Arjuna1356/WholeSkyImager/Hardware/Drawings/BottomClipDrawing.jpg

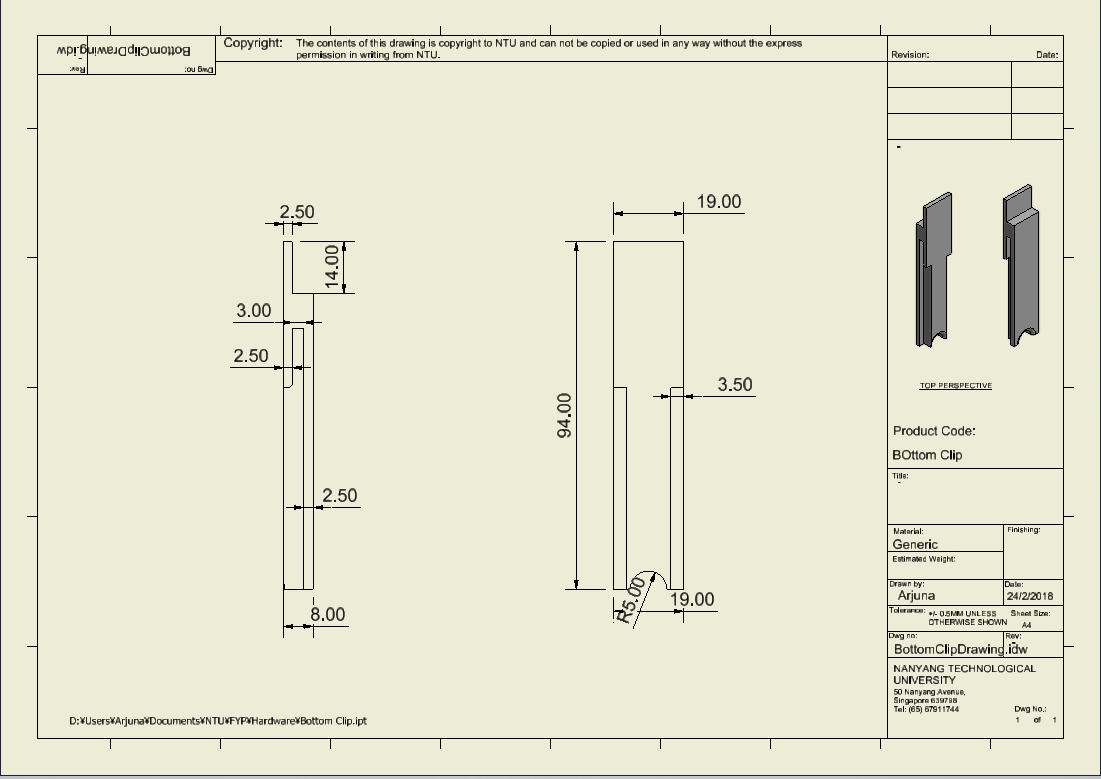
Hardware/Drawings/BottomClipDrawing.jpg
