Arjuna1356/WholeSkyImager/Hardware/Drawings/BottomDrawing.jpg

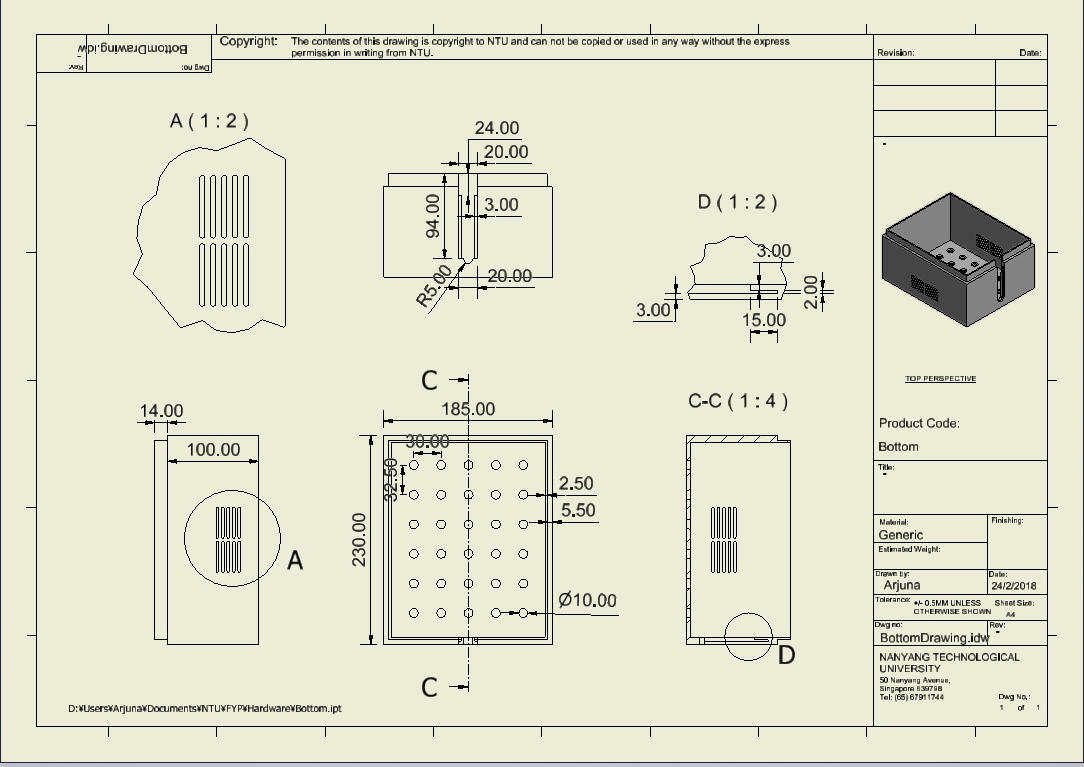
Hardware/Drawings/BottomDrawing.jpg
