Arjuna1356/WholeSkyImager/Hardware/Drawings/BottomRoofDrawing.jpg

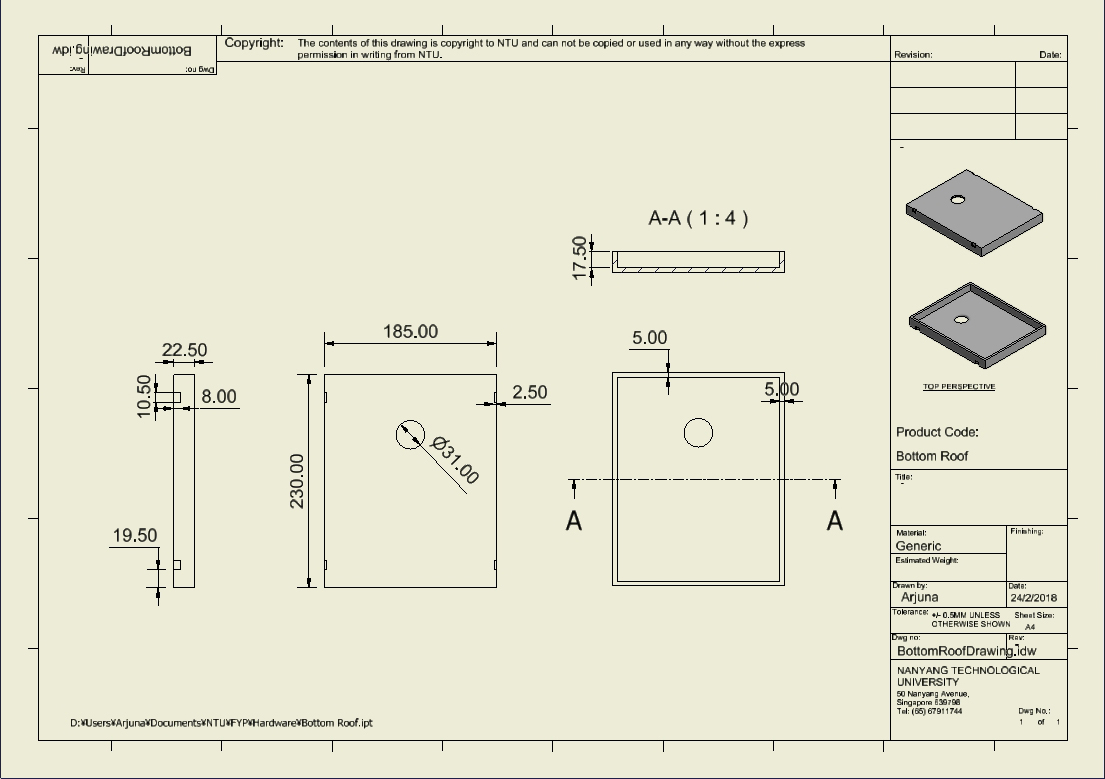
Hardware/Drawings/BottomRoofDrawing.jpg
