Arjuna1356/WholeSkyImager/Hardware/Drawings/DomeClipDrawing.jpg

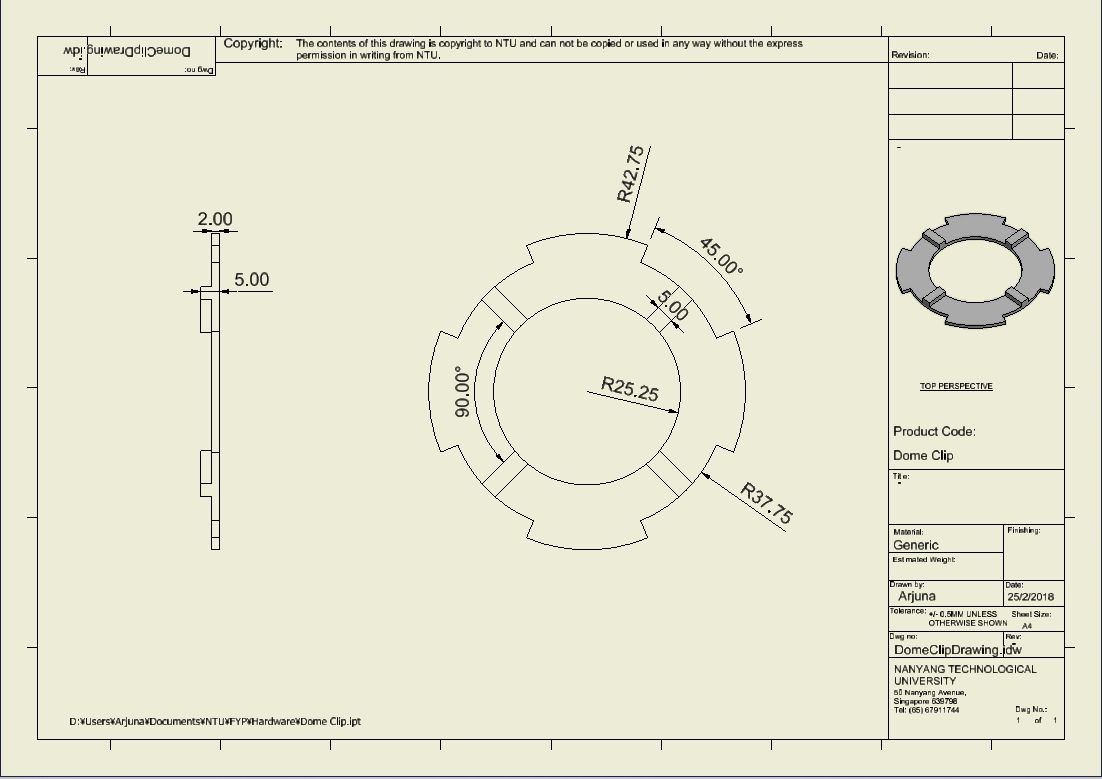
Hardware/Drawings/DomeClipDrawing.jpg
