Arjuna1356/WholeSkyImager/Hardware/Drawings/PlatformPinDrawing.jpg

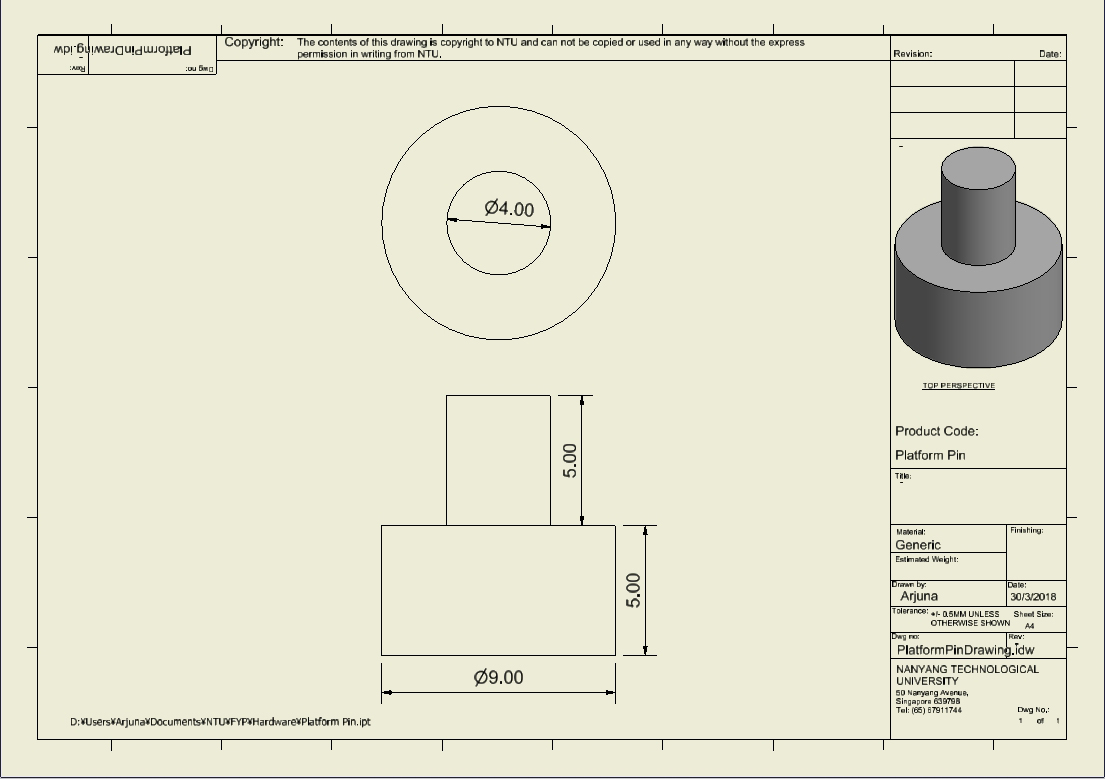
Hardware/Drawings/PlatformPinDrawing.jpg
