Arjuna1356/WholeSkyImager/Hardware/Drawings/RoofExtensionLeftAttachmentDrawing.jpg

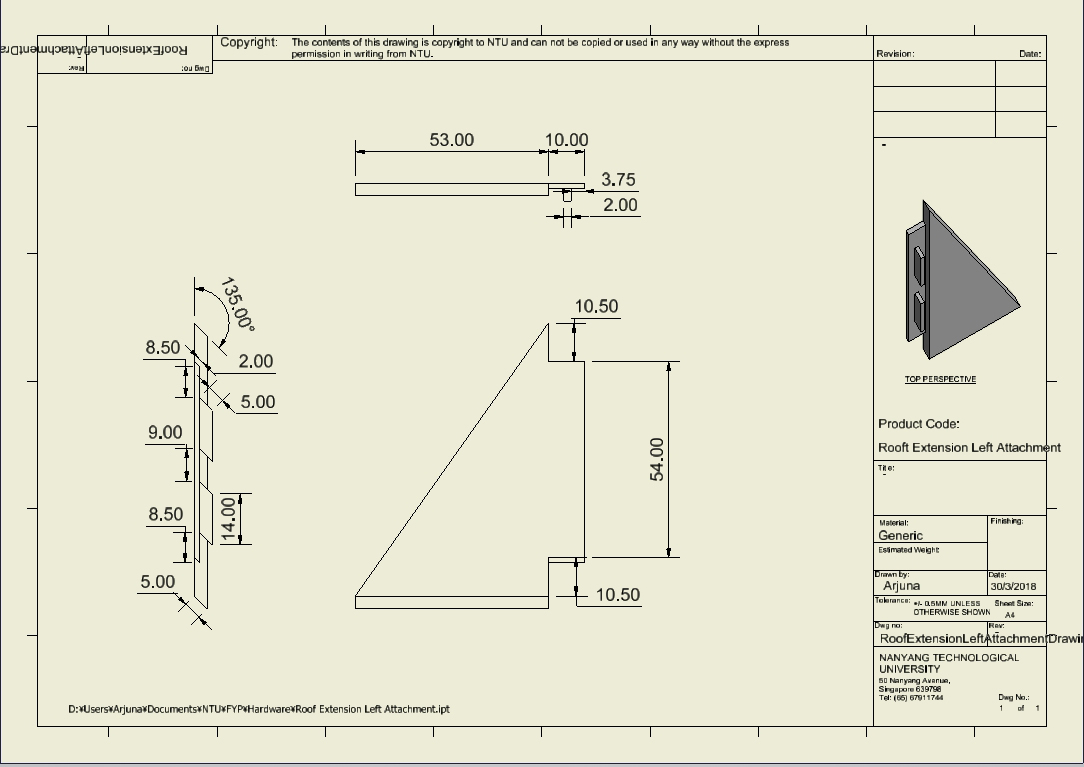
Hardware/Drawings/RoofExtensionLeftAttachmentDrawing.jpg
