Arjuna1356/WholeSkyImager/Hardware/Drawings/RoofExtensionRightAttachmentDrawing.jpg

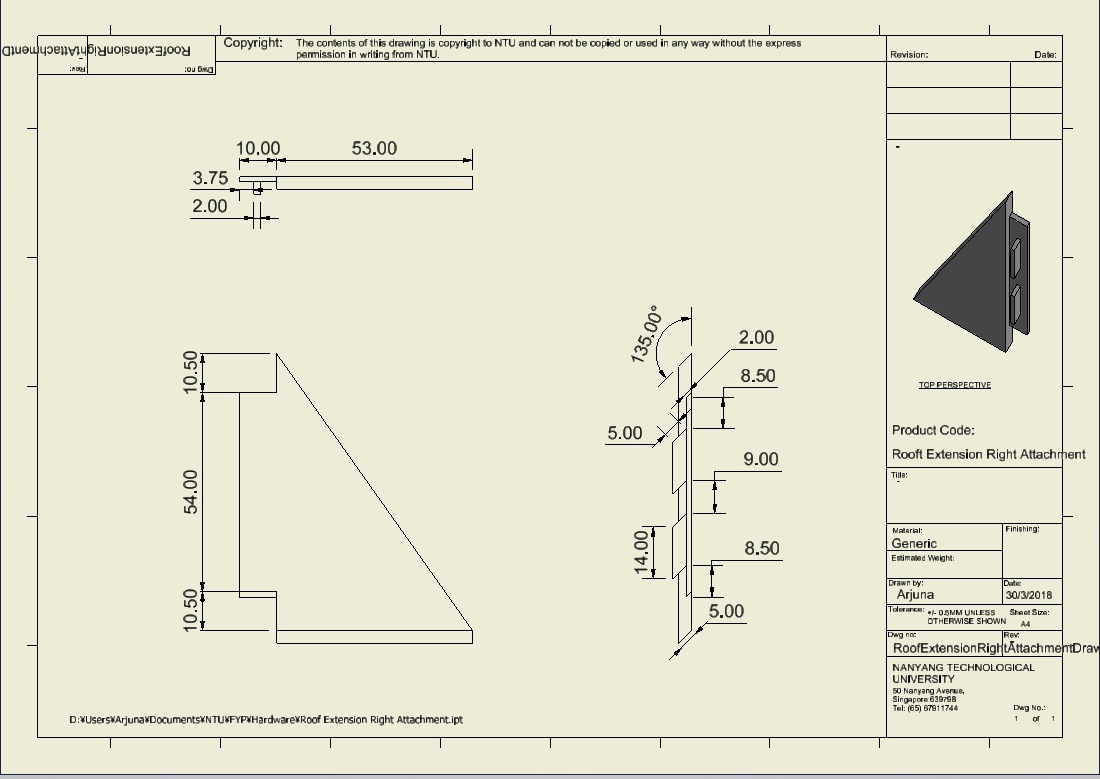
Hardware/Drawings/RoofExtensionRightAttachmentDrawing.jpg
