Arjuna1356/WholeSkyImager/Hardware/Drawings/RoofLengthExtensionDrawing.jpg

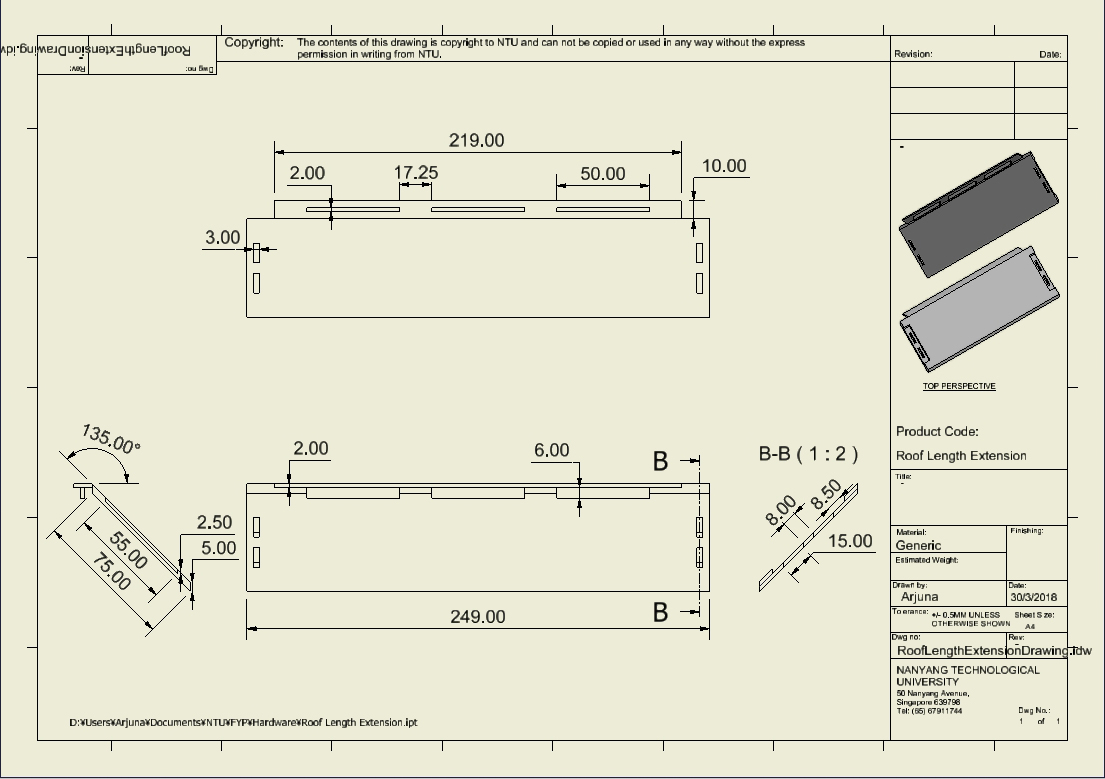
Hardware/Drawings/RoofLengthExtensionDrawing.jpg
