Arjuna1356/WholeSkyImager/Hardware/Drawings/RoofWidthExtensionDrawing.jpg

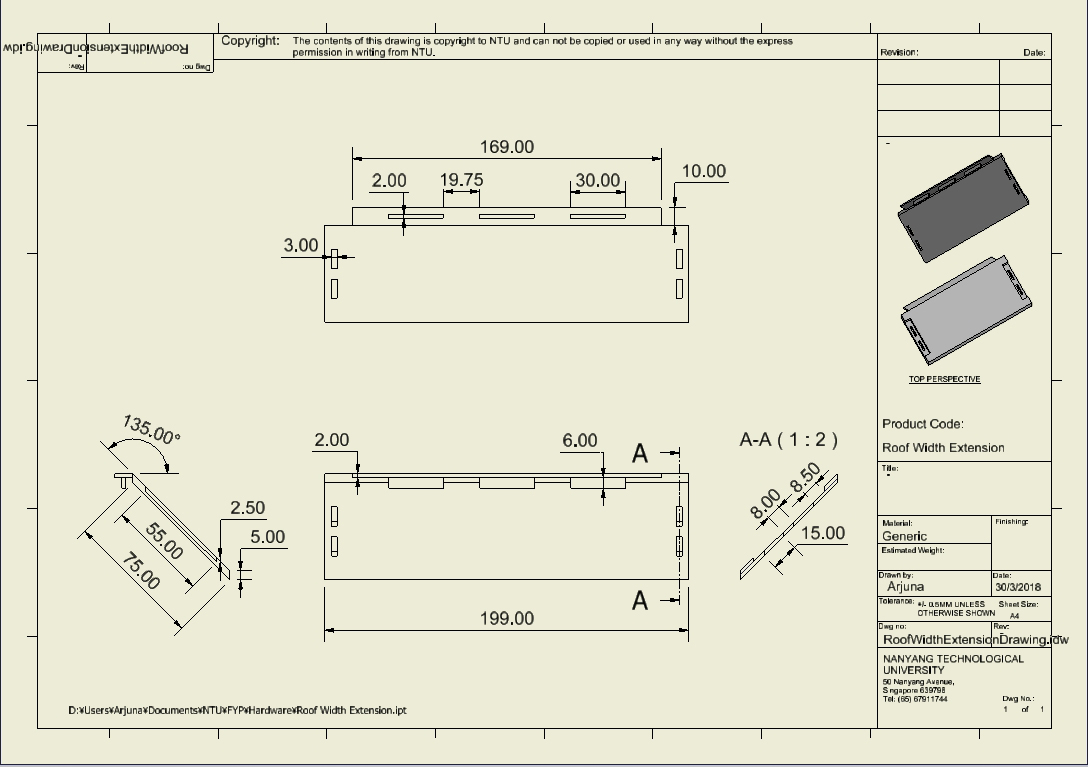
Hardware/Drawings/RoofWidthExtensionDrawing.jpg
