Arjuna1356/WholeSkyImager/Hardware/Drawings/TopRoofDrawing.jpg

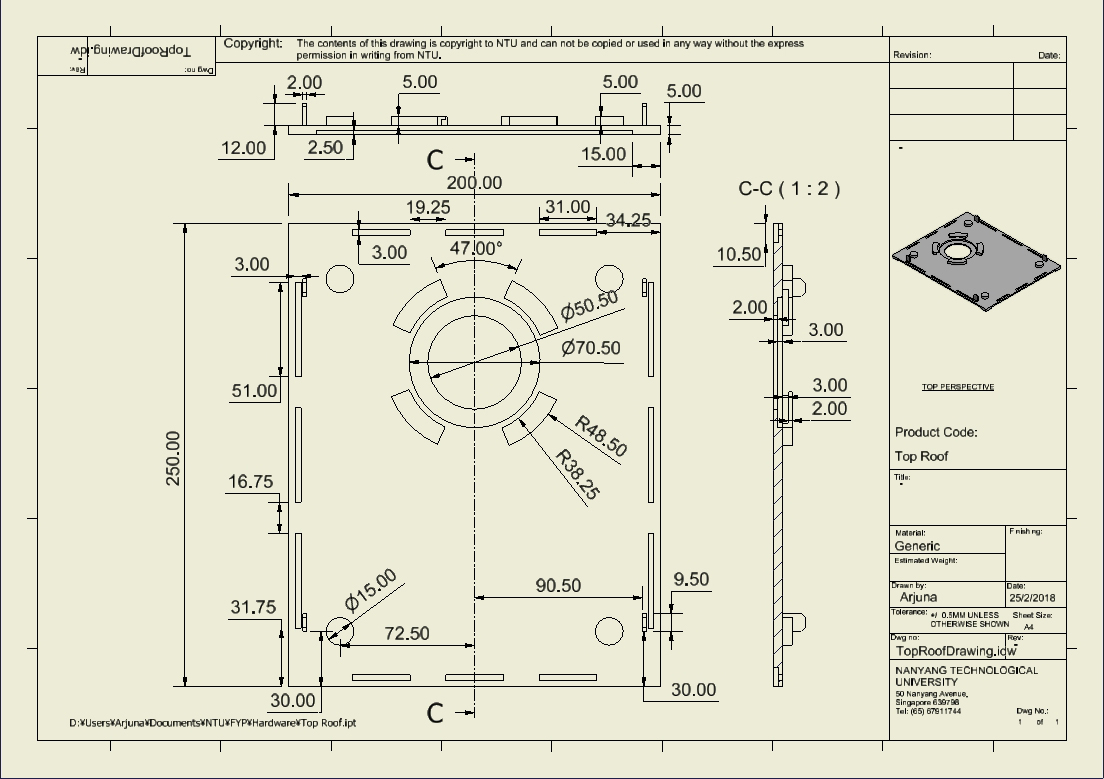
Hardware/Drawings/TopRoofDrawing.jpg
