Arjuna1356/WholeSkyImager/Hardware/3D Printing/Roof Extension Right Attachment.stl

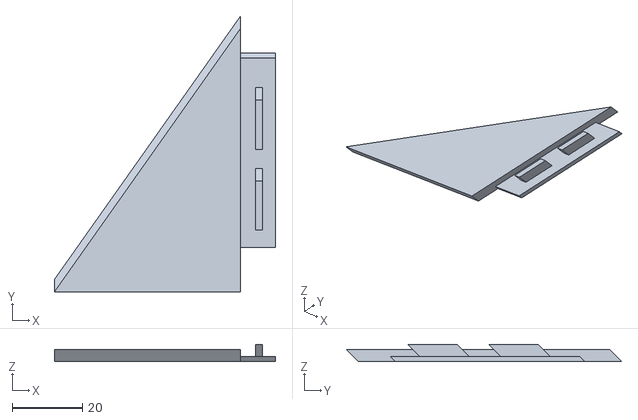
[picture p127: CAD file, 2018-04-01]
Hardware/3D Printing/Roof Extension Right Attachment.stl
63.0 x 78.5 x 4.95
