Arjuna1356/WholeSkyImager/Hardware/3D Printing/Platform-top.stl

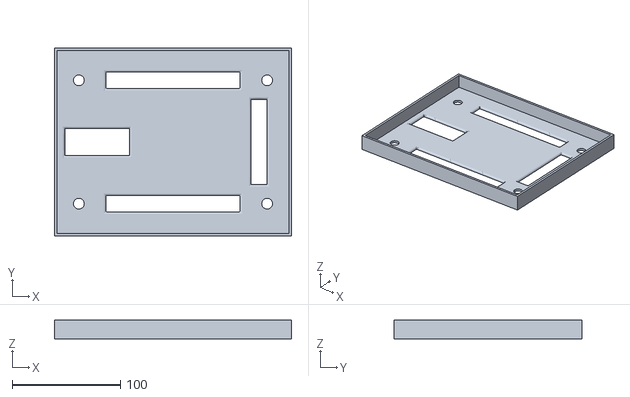
[picture p128: CAD file, 2018-04-01]
Hardware/3D Printing/Platform-top.stl
219.0 x 174.0 x 17.5
