Arjuna1356/WholeSkyImager/Hardware/3D Printing/Platform Pin.stl

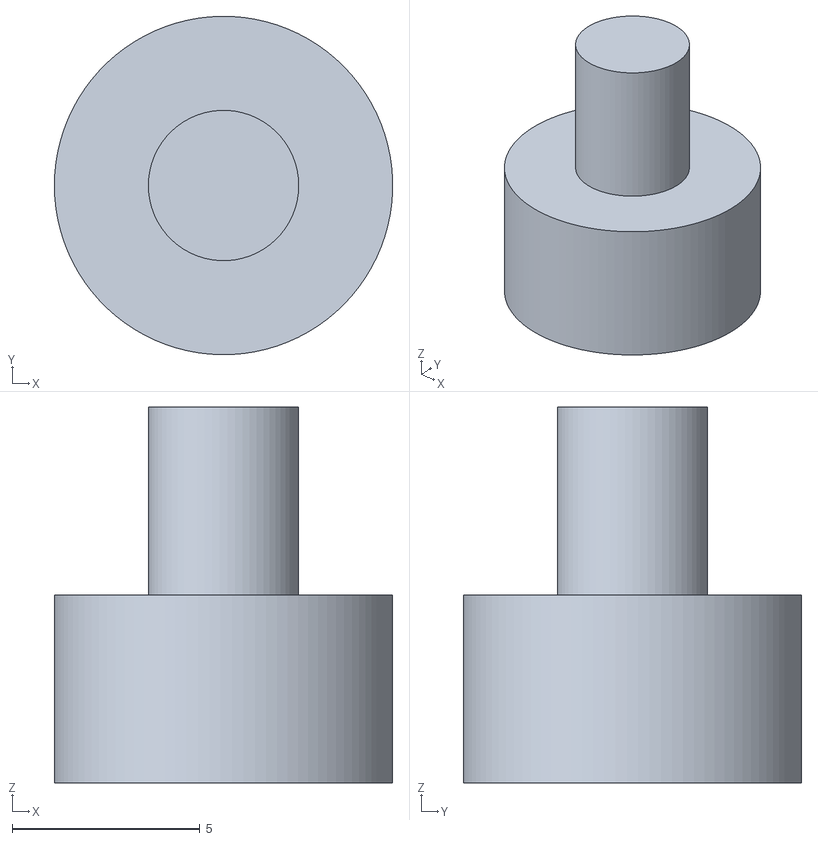
[picture p129: CAD file, 2018-04-01]
Hardware/3D Printing/Platform Pin.stl
9.00 x 9.00 x 10.0
