Arjuna1356/WholeSkyImager/Hardware/3D Printing/Roof Width Extension.stl

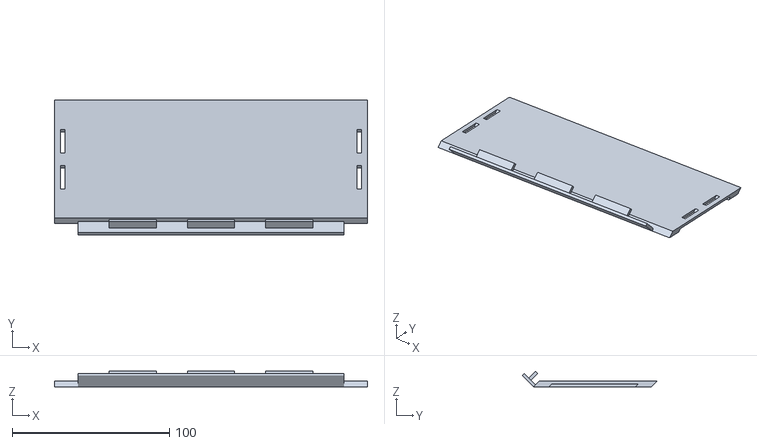
[picture p130: CAD file, 2018-04-01]
Hardware/3D Printing/Roof Width Extension.stl
199.0 x 85.6 x 9.90
