Arjuna1356/WholeSkyImager/Hardware/3D Printing/Bottom Roof.stl

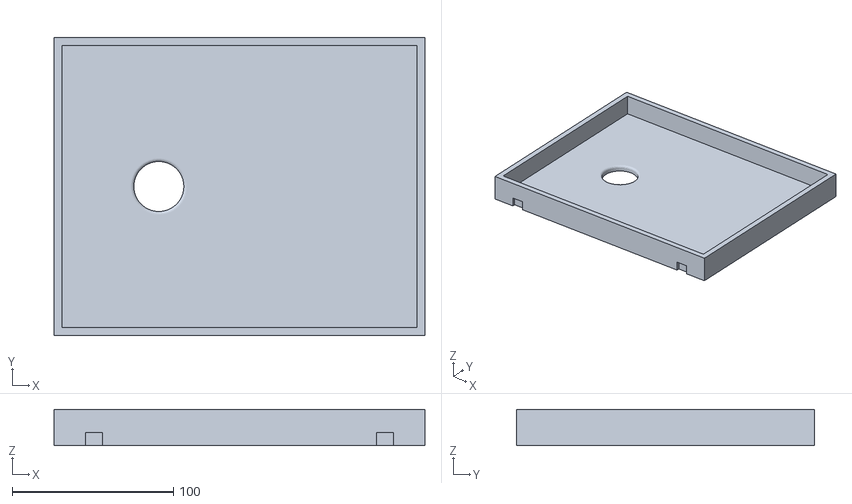
[picture p131: CAD file, 2018-04-01]
Hardware/3D Printing/Bottom Roof.stl
230.0 x 185.0 x 22.5
