Arjuna1356/WholeSkyImager/Hardware/3D Printing/Roof Length Extension.stl

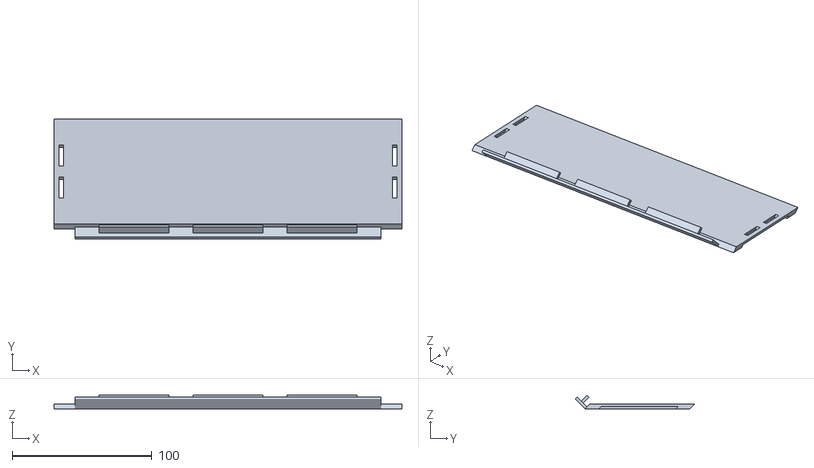
[picture p132: CAD file, 2018-04-01]
Hardware/3D Printing/Roof Length Extension.stl
249.0 x 85.6 x 9.90
