Arjuna1356/WholeSkyImager/Hardware/3D Printing/Top Roof.stl

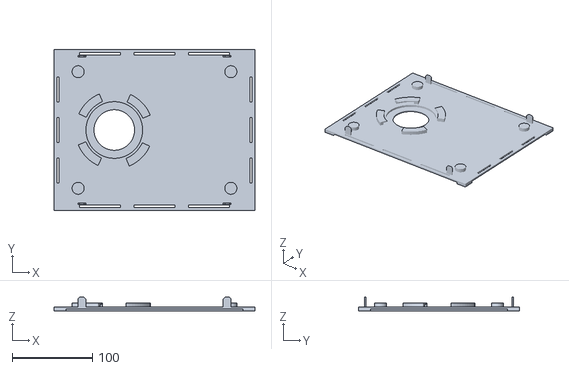
[picture p133: CAD file, 2018-04-01]
Hardware/3D Printing/Top Roof.stl
250.0 x 200.0 x 17.0
