Arjuna1356/WholeSkyImager/Hardware/3D Printing/Platform-bottom.stl

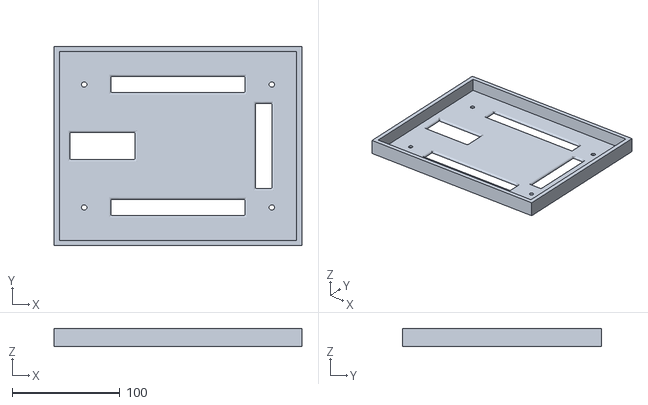
[picture p134: CAD file, 2018-04-01]
Hardware/3D Printing/Platform-bottom.stl
230.0 x 185.0 x 17.0
