Arjuna1356/WholeSkyImager/Hardware/3D Printing/Bottom.stl

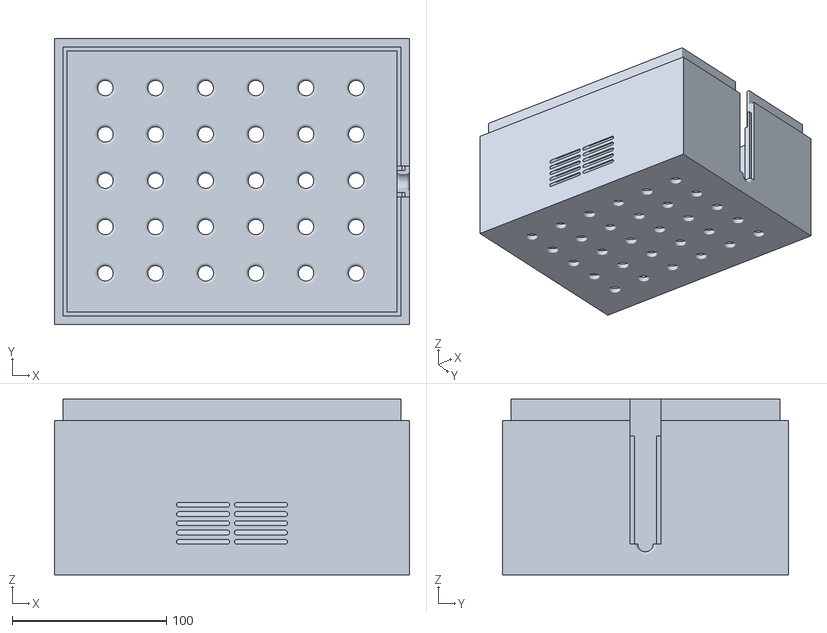
[picture p135: CAD file, 2018-04-01]
Hardware/3D Printing/Bottom.stl
230.0 x 185.0 x 114.0
