Arjuna1356/WholeSkyImager/Hardware/3D Printing/Bottom Clip.stl

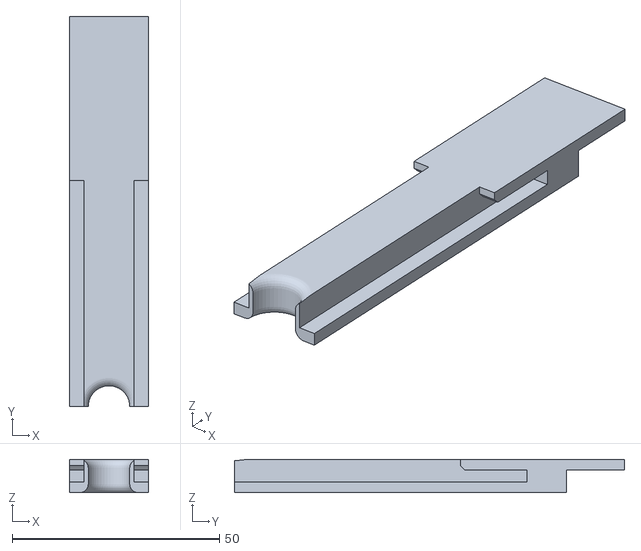
[picture p136: CAD file, 2018-04-01]
Hardware/3D Printing/Bottom Clip.stl
19.0 x 94.0 x 8.00
