Arjuna1356/WholeSkyImager/Hardware/3D Printing/Dome Clip.stl

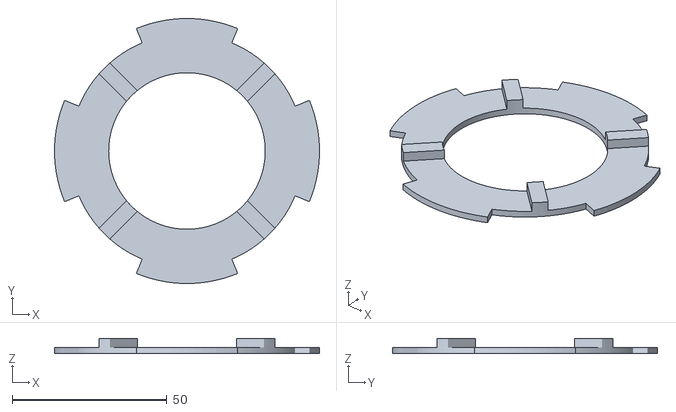
[picture p137: CAD file, 2018-04-01]
Hardware/3D Printing/Dome Clip.stl
85.5 x 85.5 x 5.00
