Arjuna1356/WholeSkyImager/(list of files, cad)

Other CAD files:
Hardware/3D Printing/Roof Extension Left Attachment.stl
Hardware/Assembly Exploded.iam
Hardware/Assembly w Phone Exploded.iam
Hardware/Assembly.iam
Hardware/AssemblyDrawing.idw
Hardware/Bottom Assembly Exploded.iam
Hardware/Bottom Assembly.iam
Hardware/Bottom Clip.ipt
Hardware/Bottom Roof.ipt
Hardware/Bottom.ipt
Hardware/BottomAssemblyDrawing.idw
Hardware/BottomClipDrawing.idw
Hardware/BottomDrawing.idw
Hardware/BottomRoofDrawing.idw
Hardware/Dome Clip.ipt
Hardware/Dome.ipt
Hardware/DomeClipDrawing.idw
Hardware/Lens.ipt
Hardware/OldVersions/Assembly Exploded.0012.iam
Hardware/OldVersions/Assembly w Phone Exploded.0002.iam
Hardware/OldVersions/Assembly.0042.iam
Hardware/OldVersions/AssemblyDrawing.0006.idw
Hardware/OldVersions/Bottom Assembly Exploded.0003.iam
Hardware/OldVersions/Bottom Assembly.0002.iam
Hardware/OldVersions/Bottom Clip.0007.ipt
Hardware/OldVersions/Bottom Roof.0051.ipt
Hardware/OldVersions/Bottom.0019.ipt
Hardware/OldVersions/BottomAssemblyDrawing.0002.idw
Hardware/OldVersions/BottomClipDrawing.0002.idw
Hardware/OldVersions/BottomDrawing.0003.idw
Hardware/OldVersions/BottomDrawing.0004.idw
Hardware/OldVersions/BottomRoofDrawing.0002.idw
Hardware/OldVersions/Dome Clip.0011.ipt
Hardware/OldVersions/Dome.0009.ipt
Hardware/OldVersions/DomeClipDrawing.0002.idw
Hardware/OldVersions/Lens.0008.ipt
Hardware/OldVersions/Phone.0003.ipt
Hardware/OldVersions/Platform Assembly Exploded.0002.iam
Hardware/OldVersions/Platform Assembly.0004.iam
Hardware/OldVersions/Platform Pin.0004.ipt
Hardware/OldVersions/Platform-bottom.0013.ipt
Hardware/OldVersions/Platform-top.0013.ipt
Hardware/OldVersions/Platform.0017.ipt
Hardware/OldVersions/PlatformAssemblyDrawing.0003.idw
Hardware/OldVersions/PlatformPinDrawing.0001.idw
Hardware/OldVersions/Reduced Bottom Roof.0038.ipt
Hardware/OldVersions/Reduced Bottom.0011.ipt
Hardware/OldVersions/Reduced Platform .0013.ipt
Hardware/OldVersions/Reduced Top Roof.0027.ipt
Hardware/OldVersions/Roof Clip.0011.ipt
Hardware/OldVersions/Roof Extension Assembly Exploded.0001.iam
Hardware/OldVersions/Roof Extension Assembly.0009.iam
Hardware/OldVersions/Roof Extension Left Attachment.0002.ipt
Hardware/OldVersions/Roof Extension Right Attachment.0002.ipt
Hardware/OldVersions/Roof Length Extension.0011.ipt
Hardware/OldVersions/Roof Width Extension.0015.ipt
Hardware/OldVersions/RoofExtensionLeftAttachmentDrawing.0001.idw
Hardware/OldVersions/RoofLengthExtensionDrawing.0002.idw
Hardware/OldVersions/RoofWidthExtensionDrawing.0001.idw
Hardware/OldVersions/Rooft Extension Left Attachment.0001.ipt
Hardware/OldVersions/Rooft Extension Right Attachment.0001.ipt
Hardware/OldVersions/Spacer.0004.ipt
Hardware/OldVersions/Top Roof Assembly Exploded.0002.iam
Hardware/OldVersions/Top Roof Assembly.0003.iam
Hardware/OldVersions/Top Roof Assembly.0004.iam
Hardware/OldVersions/Top Roof.0052.ipt
Hardware/OldVersions/TopRoofAssemblyDrawing.0001.iam
Hardware/OldVersions/TopRoofAssemblyDrawing.0003.idw
Hardware/OldVersions/TopRoofDrawing.0003.idw
Hardware/Phone.ipt
Hardware/Platform Assembly Exploded.iam
Hardware/Platform Assembly.iam
Hardware/Platform Pin.ipt
Hardware/Platform-bottom.ipt
Hardware/Platform-top.ipt
Hardware/Platform.ipt
Hardware/PlatformAssemblyDrawing.idw
Hardware/PlatformPinDrawing.idw
Hardware/Reduced Bottom Roof.ipt
Hardware/Reduced Bottom.ipt
Hardware/Reduced Platform .ipt
Hardware/Reduced Top Roof.ipt
Hardware/Roof Clip.ipt
Hardware/Roof Extension Assembly Exploded.iam
Hardware/Roof Extension Assembly.iam
Hardware/Roof Extension Left Attachment.ipt
Hardware/Roof Extension Right Attachment.ipt
Hardware/Roof Length Extension.ipt
Hardware/Roof Width Extension.ipt
Hardware/RoofExtensionAssemblyDrawing.idw
Hardware/RoofExtensionLeftAttachmentDrawing.idw
Hardware/RoofExtensionRightAttachmentDrawing.idw
Hardware/RoofLengthExtensionDrawing.idw
Hardware/RoofWidthExtensionDrawing.idw
Hardware/Spacer.ipt
Hardware/Top Roof Assembly Exploded.iam
Hardware/Top Roof Assembly.iam
Hardware/Top Roof.ipt
Hardware/TopRoofAssemblyDrawing.idw
Hardware/TopRoofDrawing.idw
