Arjuna1356/WholeSkyImager/Hardware/Drawings/AssemblyDrawing.jpg

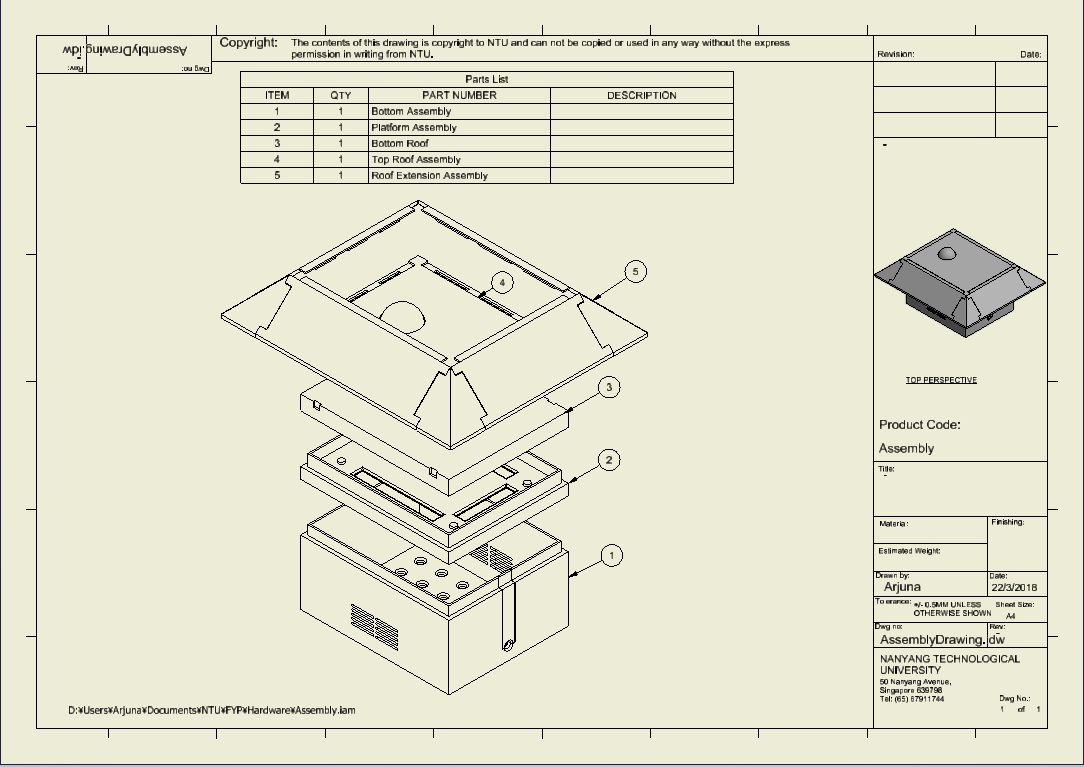
Hardware/Drawings/AssemblyDrawing.jpg
