Arjuna1356/WholeSkyImager/Hardware/Drawings/BottomAssemblyDrawing.jpg

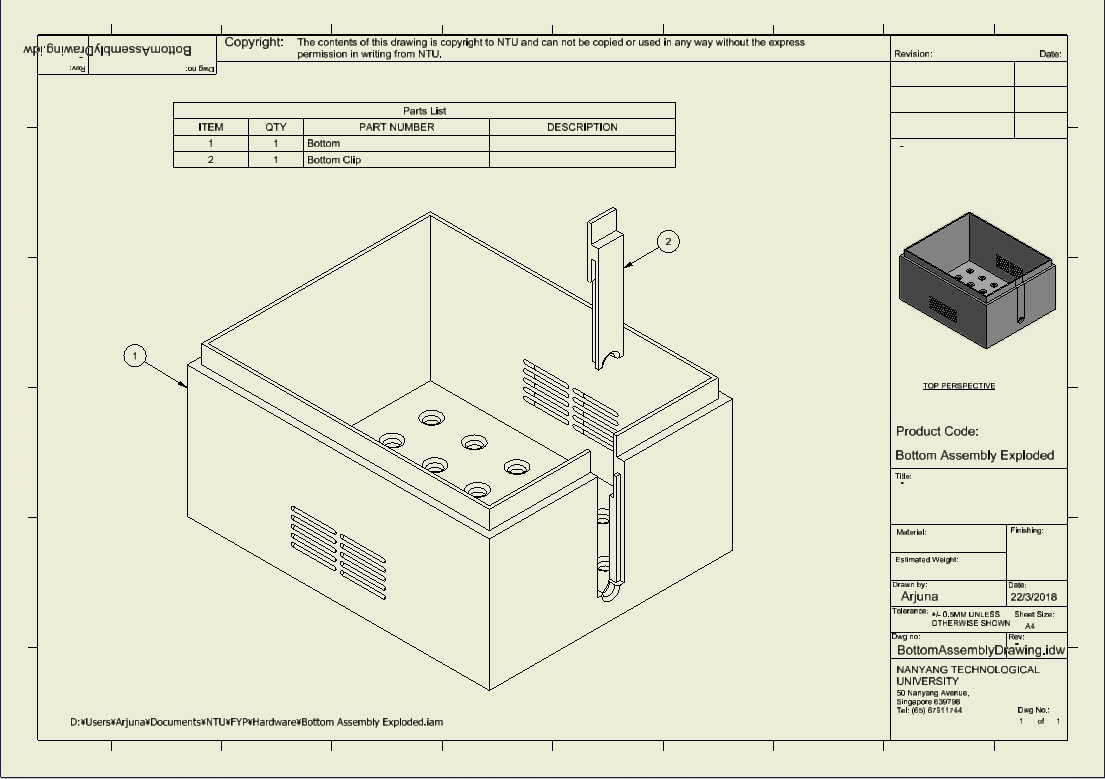
Hardware/Drawings/BottomAssemblyDrawing.jpg
