Arjuna1356/WholeSkyImager/Hardware/Drawings/PlatformAssemblyDrawing.jpg

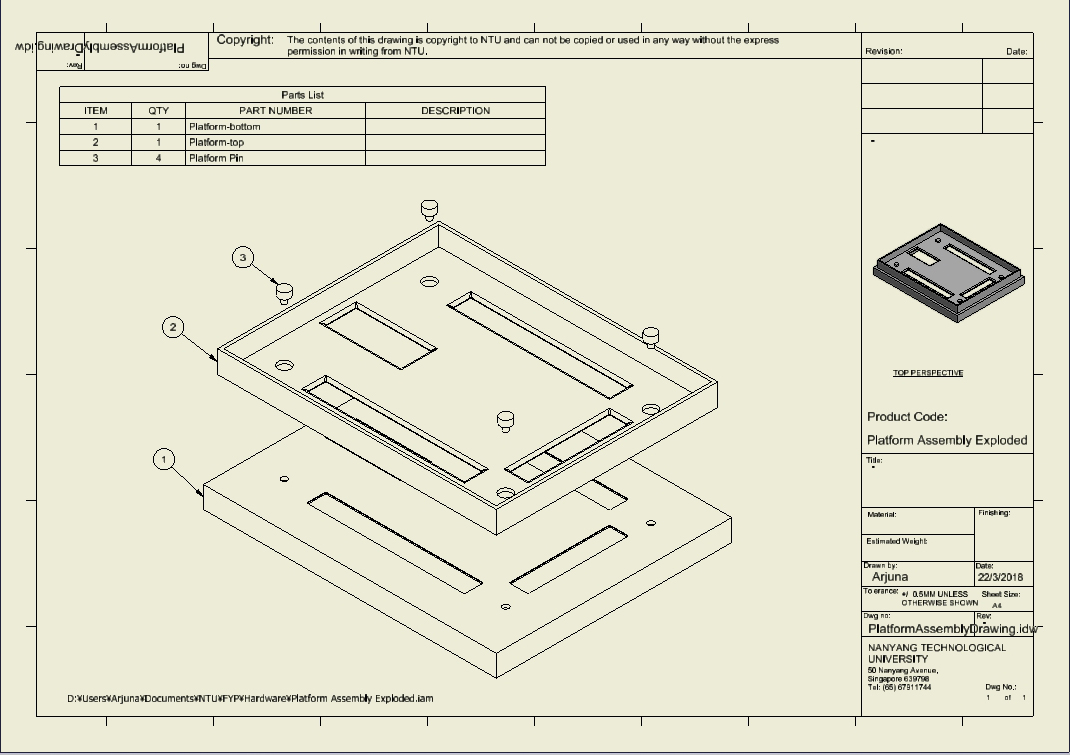
Hardware/Drawings/PlatformAssemblyDrawing.jpg
