Arjuna1356/WholeSkyImager/Hardware/Drawings/RoofExtensionAssemblyDrawing.jpg

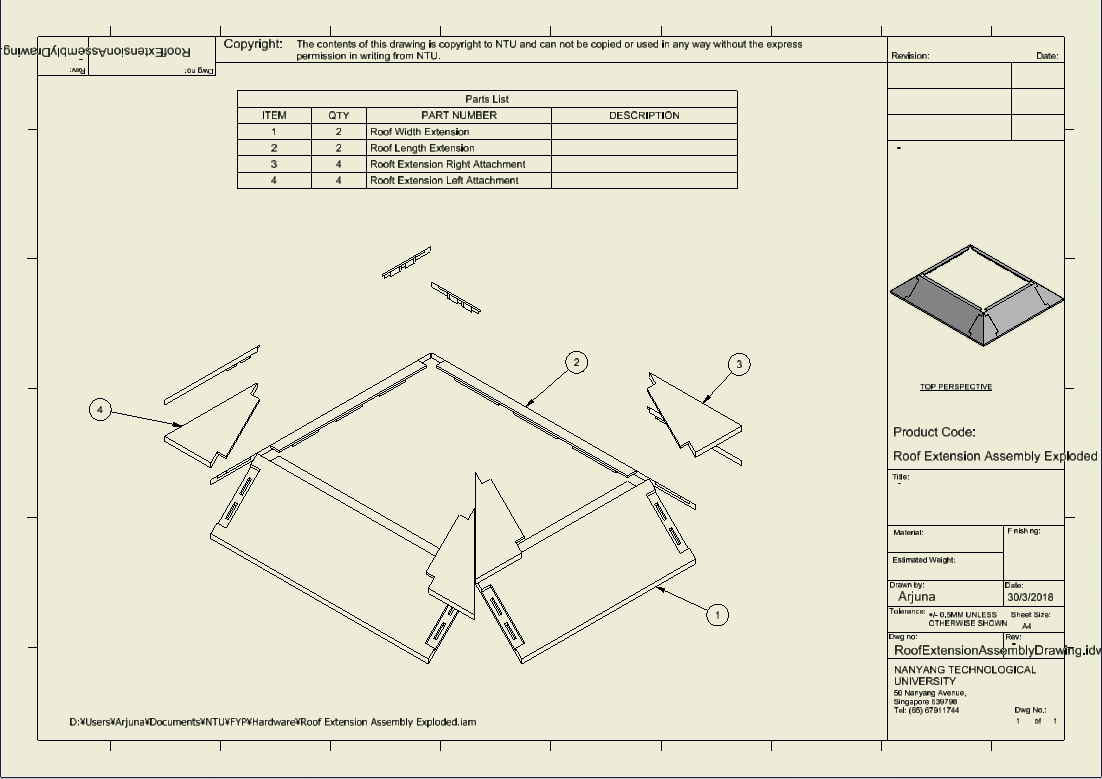
Hardware/Drawings/RoofExtensionAssemblyDrawing.jpg
