Arjuna1356/WholeSkyImager/Hardware/Drawings/TopRoofAssemblyDrawing.jpg

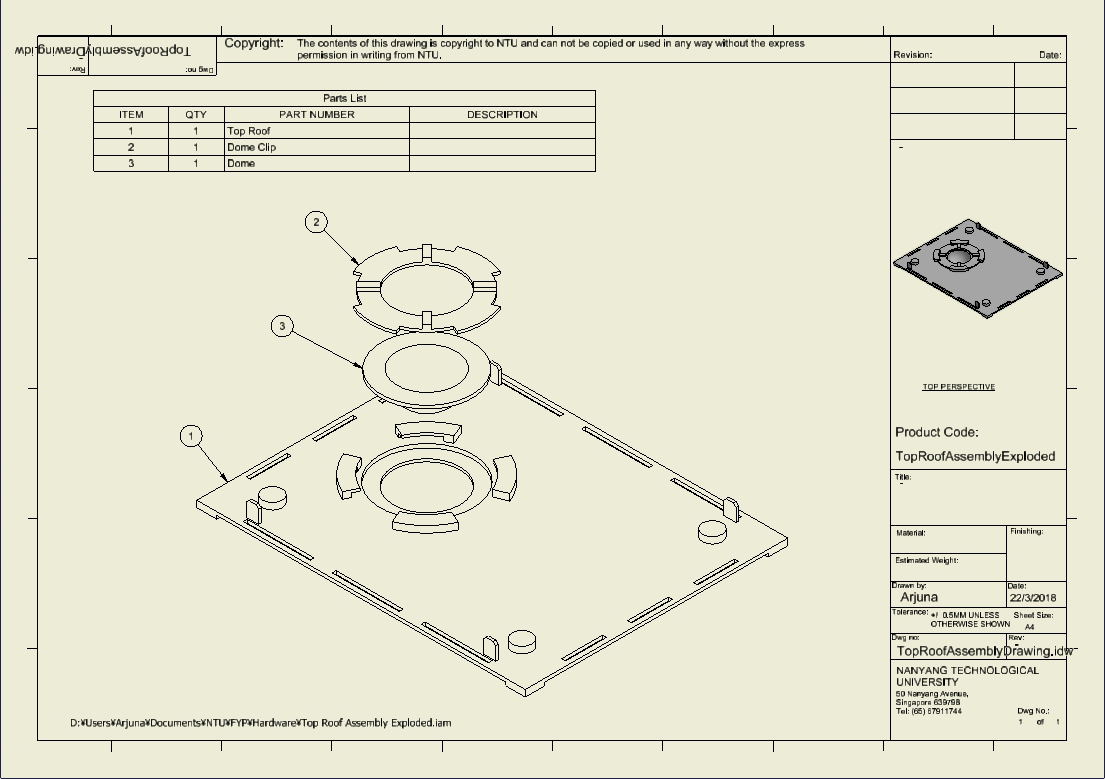
Hardware/Drawings/TopRoofAssemblyDrawing.jpg
